mdub555/SplitFlapDisplay/CAD Files/v2/Character Drum - Character Drum Main.FCStd

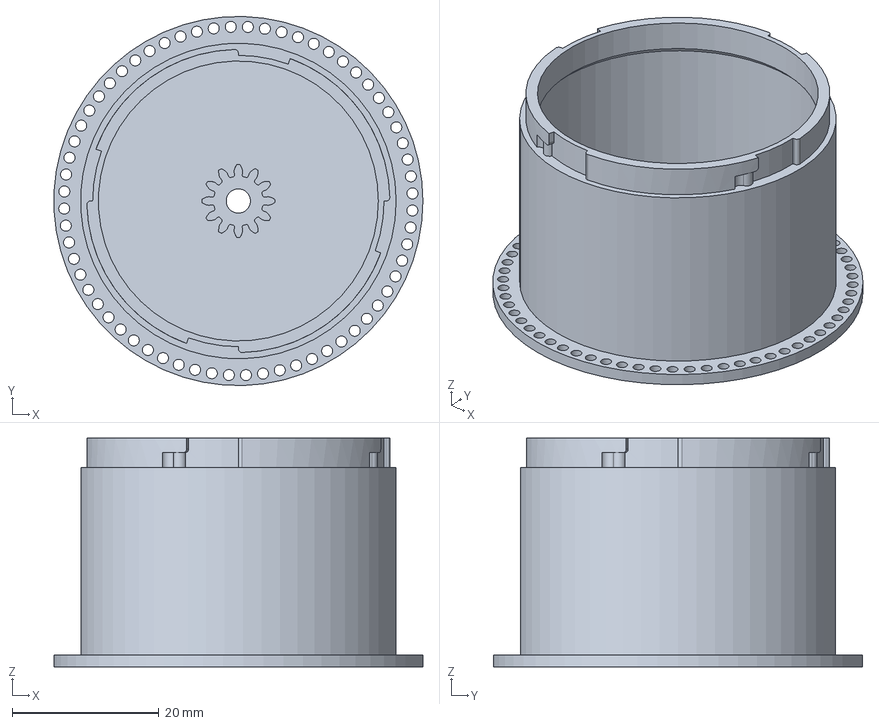
[picture p1: CAD file, 2026-08-30]
CAD Files/v2/Character Drum - Character Drum Main.FCStd
50.3 x 50.3 x 31.2 mm
