mdub555/SplitFlapDisplay/CAD Files/64FlapsWithLetters (parts and bambu print profile)/Flap 57 - Blank.FCStd

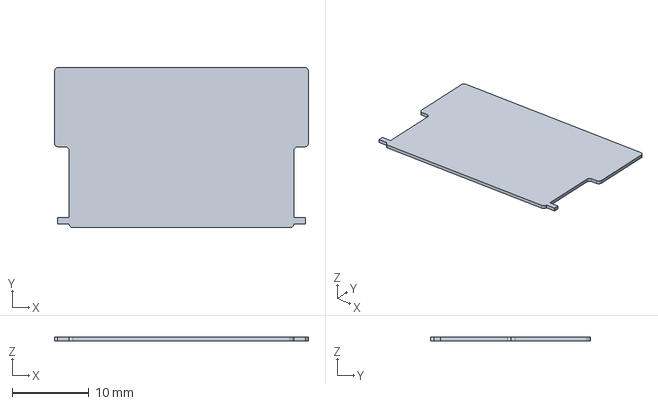
[picture p2: CAD file, 2026-08-14]
CAD Files/64FlapsWithLetters (parts and bambu print profile)/Flap 57 - Blank.FCStd
33.1 x 20.9 x 0.48 mm
