mdub555/SplitFlapDisplay/CAD Files/v2/Module Enclosure - Enclosure Cover Back.FCStd

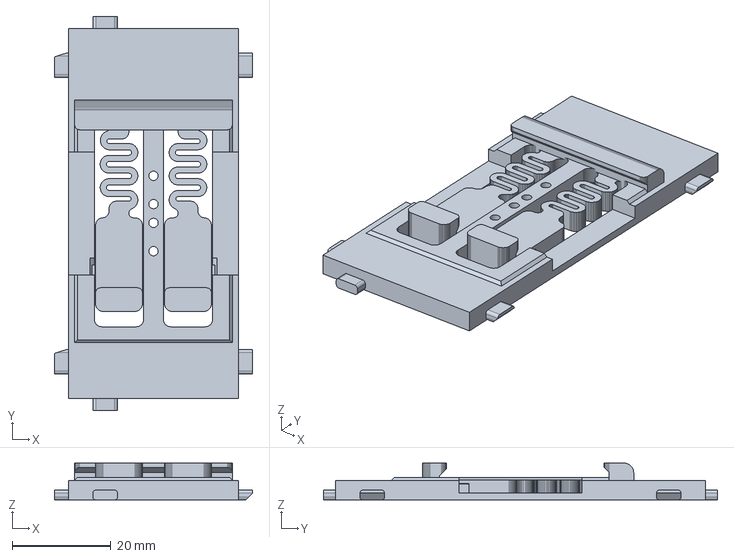
[picture p3: CAD file, 2026-09-11]
CAD Files/v2/Module Enclosure - Enclosure Cover Back.FCStd
40.2 x 80.0 x 7.50 mm
