mdub555/SplitFlapDisplay/PCBs/bus-board-8-module/bus-board-8-module.step

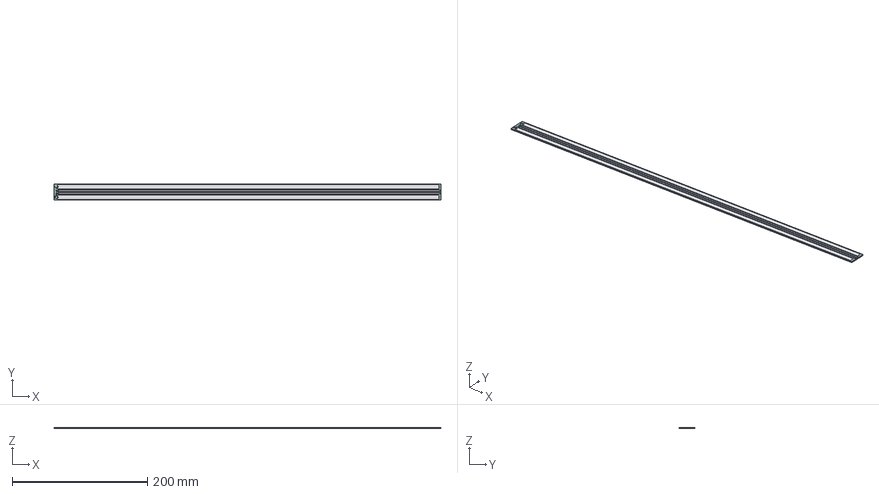
[picture p4: CAD file, 2026-08-30]
PCBs/bus-board-8-module/bus-board-8-module.step
572.6 x 24.0 x 1.62 mm
SplitFlapBusBoard_pad
SplitFlapBusBoard_silkscreen
SplitFlapBusBoard_PCB
