mdub555/SplitFlapDisplay/CAD Files/v2/Din Rail Spacer.FCStd

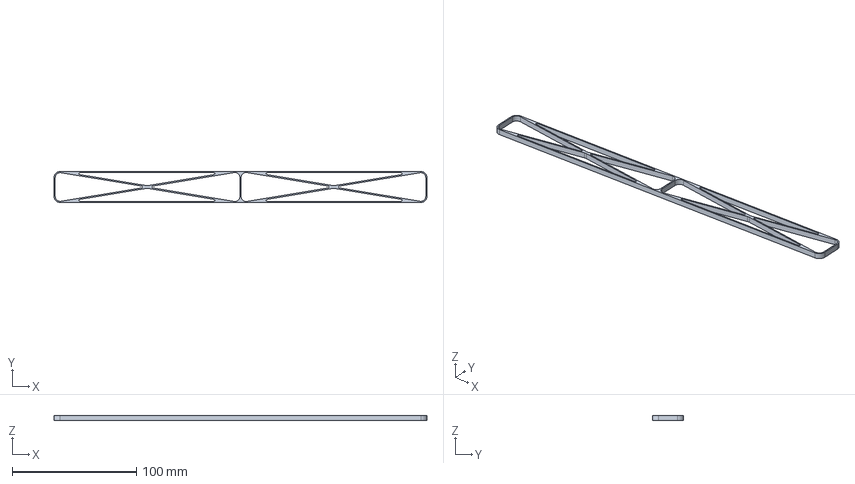
[picture p5: CAD file, 2026-09-11]
CAD Files/v2/Din Rail Spacer.FCStd
300.0 x 25.0 x 4.20 mm
