mdub555/SplitFlapDisplay/CAD Files/v2/Module Enclosure - Enclosure Cover Top.FCStd

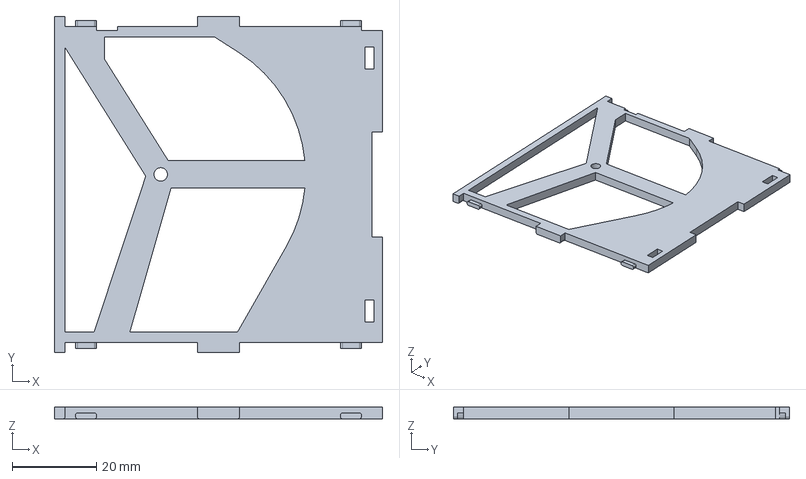
[picture p6: CAD file, 2026-08-30]
CAD Files/v2/Module Enclosure - Enclosure Cover Top.FCStd
78.0 x 80.0 x 2.80 mm
