mdub555/SplitFlapDisplay/CAD Files/v2/Flap Set Holder.FCStd

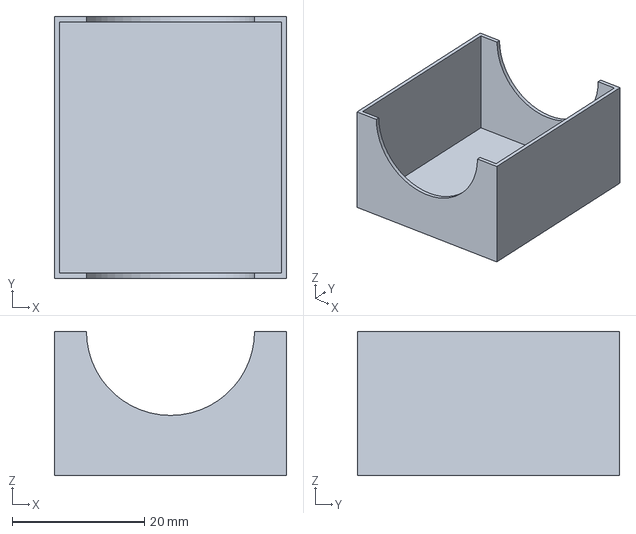
[picture p7: CAD file, 2026-08-30]
CAD Files/v2/Flap Set Holder.FCStd
35.1 x 39.6 x 21.8 mm
