mdub555/SplitFlapDisplay/CAD Files/v2/Character Drum - Character Drum Lip.FCStd

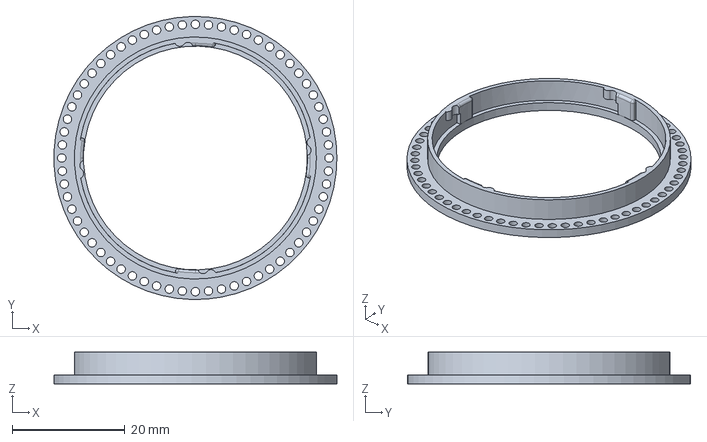
[picture p8: CAD file, 2026-08-30]
CAD Files/v2/Character Drum - Character Drum Lip.FCStd
50.3 x 50.3 x 5.60 mm
