mdub555/SplitFlapDisplay/CAD Files/v2/Center Gear.FCStd

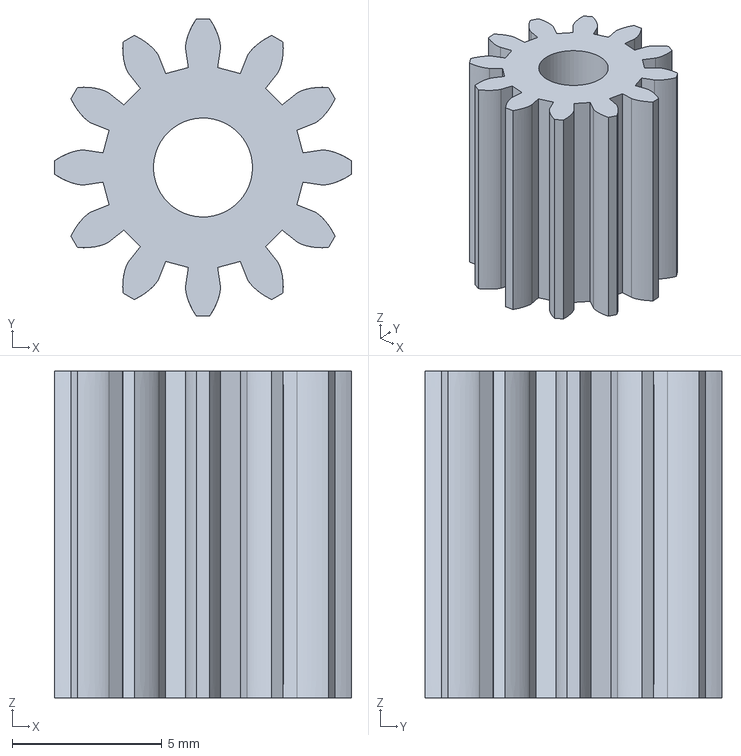
[picture p9: CAD file, 2026-08-14]
CAD Files/v2/Center Gear.FCStd
9.92 x 9.92 x 10.9 mm
