mdub555/SplitFlapDisplay/CAD Files/v2/Wire Retainer.FCStd

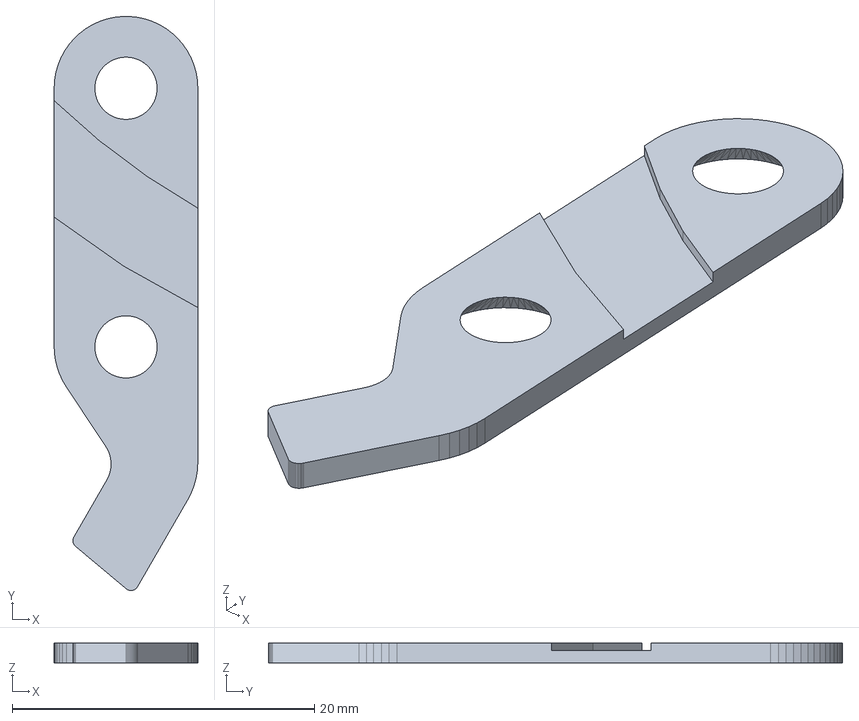
[picture p10: CAD file, 2026-08-14]
CAD Files/v2/Wire Retainer.FCStd
9.52 x 38.0 x 1.30 mm
