mdub555/SplitFlapDisplay/CAD Files/v2/Gear Plate.FCStd

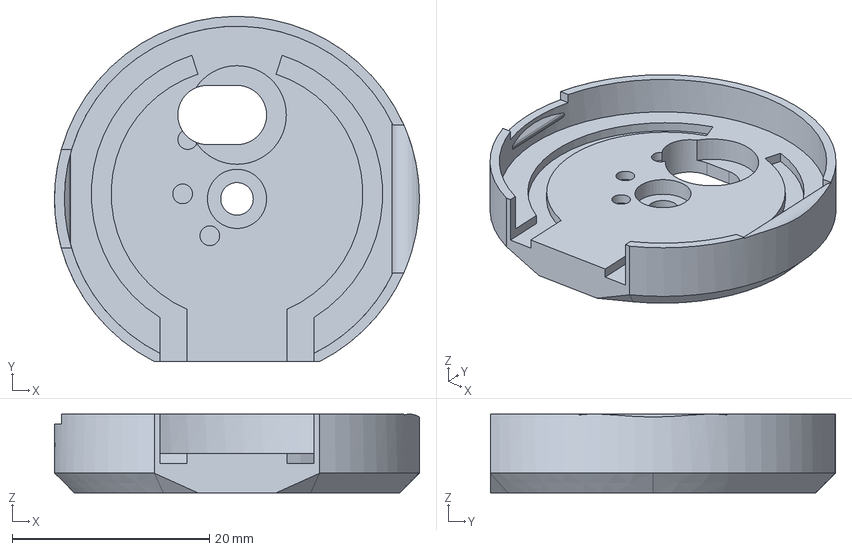
[picture p11: CAD file, 2026-08-14]
CAD Files/v2/Gear Plate.FCStd
37.0 x 35.0 x 8.00 mm
