mdub555/SplitFlapDisplay/CAD Files/v2/Motor Gear.FCStd

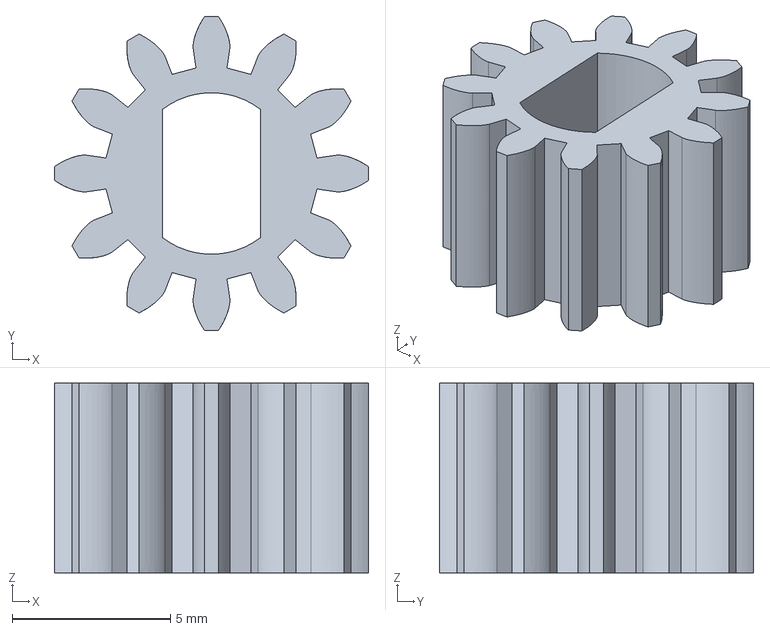
[picture p12: CAD file, 2026-08-14]
CAD Files/v2/Motor Gear.FCStd
9.92 x 9.92 x 6.00 mm
