mdub555/SplitFlapDisplay/CAD Files/v2/Module Enclosure - Enclosure Cover Bottom.FCStd

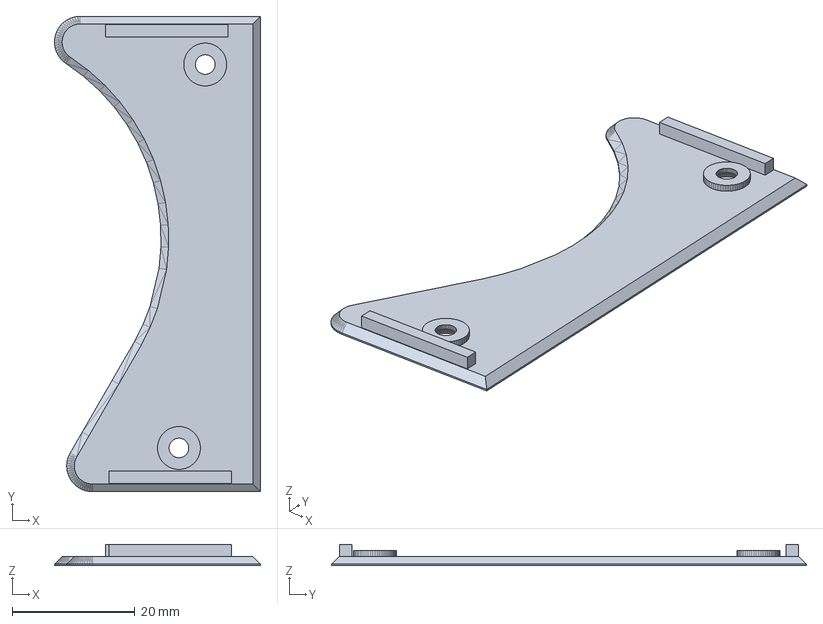
[picture p13: CAD file, 2026-08-14]
CAD Files/v2/Module Enclosure - Enclosure Cover Bottom.FCStd
33.6 x 77.6 x 3.50 mm
