mdub555/SplitFlapDisplay/frontend/setup.txt

$ sudo rpi-update
$ sudo apt update
$ sudo apt upgrade
# set up wifi again with nmtui
$ sudo apt-get install neovim
$ sudo apt-get install tmux

# install docker: https://docs.docker.com/engine/install/raspberry-pi-os/
$ sudo apt-get update
$ sudo apt-get install ca-certificates curl
$ sudo install -m 0755 -d /etc/apt/keyrings
$ sudo curl -fsSL https://download.docker.com/linux/raspbian/gpg -o /etc/apt/keyrings/docker.asc
$ sudo chmod a+r /etc/apt/keyrings/docker.asc
$ echo \
  "deb [arch=$(dpkg --print-architecture) signed-by=/etc/apt/keyrings/docker.asc] https://download.docker.com/linux/debian \
  $(. /etc/os-release && echo "$VERSION_CODENAME") stable" | \
  sudo tee /etc/apt/sources.list.d/docker.list > /dev/null
$ sudo apt-get update
$ sudo apt-get install docker-ce docker-ce-cli containerd.io docker-buildx-plugin docker-compose-plugin
$ sudo groupadd docker
$ sudo usermod -aG docker $USER
$ newgrp docker

# install comitup: https://github.com/davesteele/comitup
$ sudo apt install comitup
