mdub555/SplitFlapDisplay/PCBs/bus-board-8-module/bus-board-8-module.kicad_pcb

## KiCad design PCBs/bus-board-8-module/bus-board-8-module.kicad_pcb (2026-08-30)

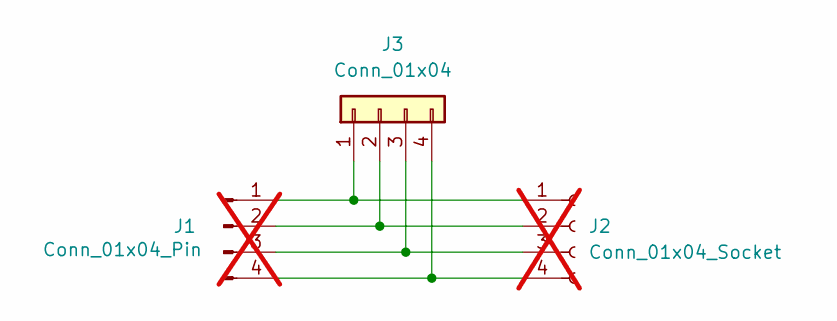
[picture p14: schematic bus-board-8-module.kicad_sch]

Parts:
J1: Conn_01x04_Pin; PinHeader_1x04_P2.54mm_Vertical; not fitted
J2: Conn_01x04_Socket; PinSocket_1x04_P2.54mm_Vertical; not fitted
J3: Conn_01x04; bus-8-5v

Connections:
unnamed: J1.1, J2.1, J3.1
unnamed: J1.2, J2.2, J3.2
unnamed: J1.3, J2.3, J3.3
unnamed: J1.4, J2.4, J3.4

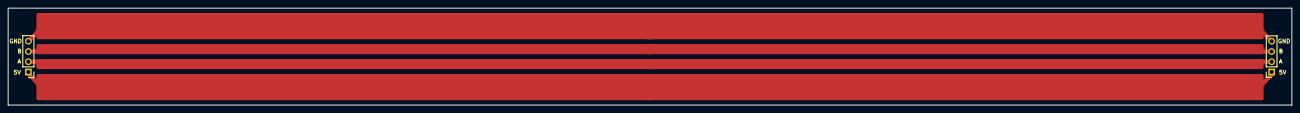
[picture p15: board bus-board-8-module.kicad_pcb from above]

Board: 2 copper layers, 318.0 x 24.0 mm, 3 parts (0 on the bottom side), 4 nets.
