mdub555/SplitFlapDisplay/PCBs/driver-v5/driver-v5.kicad_pcb

## KiCad design PCBs/driver-v5/driver-v5.kicad_pcb (2026-08-30)

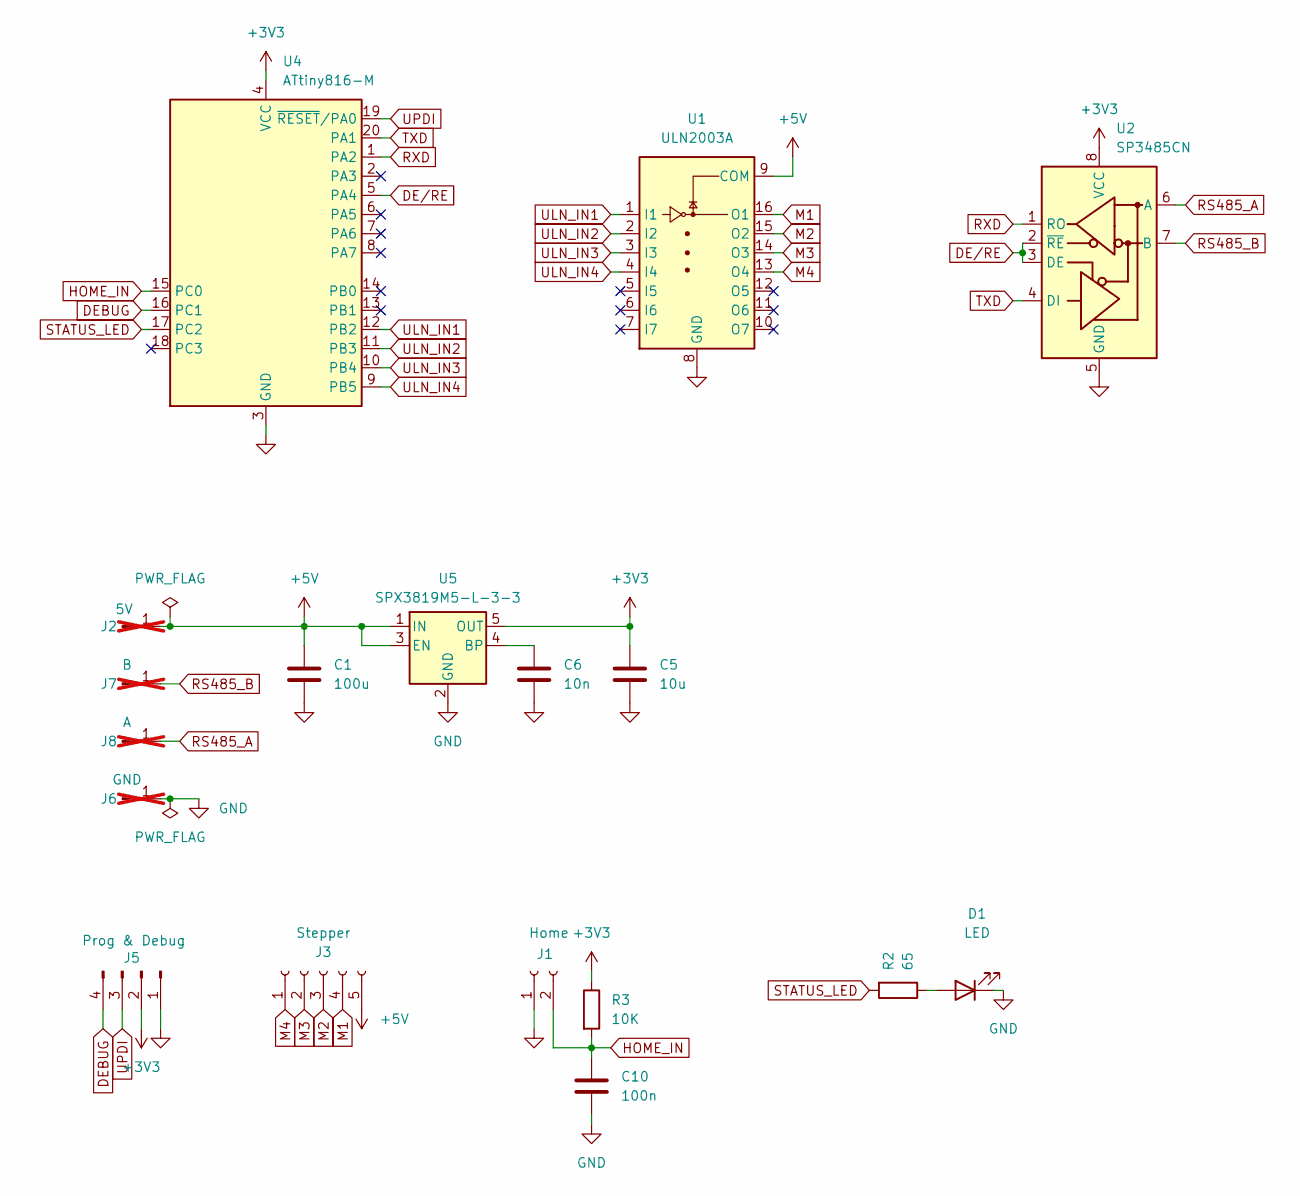
[picture p16: schematic driver-v5.kicad_sch]

Parts:
C1: 100u; C_Elec_5x5.4
C5: 10u; C_0603_1608Metric
C6: 10n; C_0603_1608Metric
C10: 100n; C_0603_1608Metric
D1: LED; LED_0603_1608Metric
J1: Home; PinSocket_1x02_P2.54mm_Vertical
J2: 5V; PinHeader_1x01_P2.54mm_Vertical; not fitted
J3: Stepper; JST_XH_B5B-XH-A_1x05_P2.50mm_Vertical
J5: Prog & Debug; PinHeader_1x04_P2.54mm_Vertical
J6: GND; PinHeader_1x01_P2.54mm_Vertical; not fitted
J7: B; PinHeader_1x01_P2.54mm_Vertical; not fitted
J8: A; PinHeader_1x01_P2.54mm_Vertical; not fitted
R2: 65; R_0603_1608Metric
R3: 10K; R_0603_1608Metric
U1: ULN2003A; SOIC-16_3.9x9.9mm_P1.27mm
U2: SP3485CN; SOIC-8_3.9x4.9mm_P1.27mm
U4: ATtiny816-M; VQFN-20-1EP_3x3mm_P0.4mm_EP1.7x1.7mm
U5: SPX3819M5-L-3-3; SOT-23-5

Connections:
+3V3: C5.1, J5.2, R3.1, U2.8 (VCC), U4.4 (VCC), U5.5 (OUT)
+5V: C1.1, J2.1 (Pin_1_1), J3.5, U1.9 (COM), U5.1 (IN), U5.3 (EN)
DEBUG: J5.4, U4.16 (PC1)
DE/RE: U2.2 (~RE), U2.3 (DE), U4.5 (PA4)
GND: C1.2, C5.2, C6.2, C10.2, D1.1 (K), J1.1, J5.1, J6.1 (Pin_1_1), U1.8 (GND), U2.5 (GND), U4.3 (GND), U4.21 (GND), U5.2 (GND)
HOME_IN: C10.1, J1.2, R3.2, U4.15 (PC0)
M1: J3.4, U1.16 (O1)
M2: J3.3, U1.15 (O2)
M3: J3.2, U1.14 (O3)
M4: J3.1, U1.13 (O4)
unnamed: D1.2 (A), R2.1
unnamed: C6.1, U5.4 (BP)
RS485_A: J8.1 (Pin_1_1), U2.6 (A)
RS485_B: J7.1 (Pin_1_1), U2.7 (B)
RXD: U2.1 (RO), U4.1 (PA2)
STATUS_LED: R2.2, U4.17 (PC2)
TXD: U2.4 (DI), U4.20 (PA1)
ULN_IN1: U1.1 (I1), U4.12 (PB2)
ULN_IN2: U1.2 (I2), U4.11 (PB3)
ULN_IN3: U1.3 (I3), U4.10 (PB4)
ULN_IN4: U1.4 (I4), U4.9 (PB5)
UPDI: J5.3, U4.19 (~RESET/PA0)

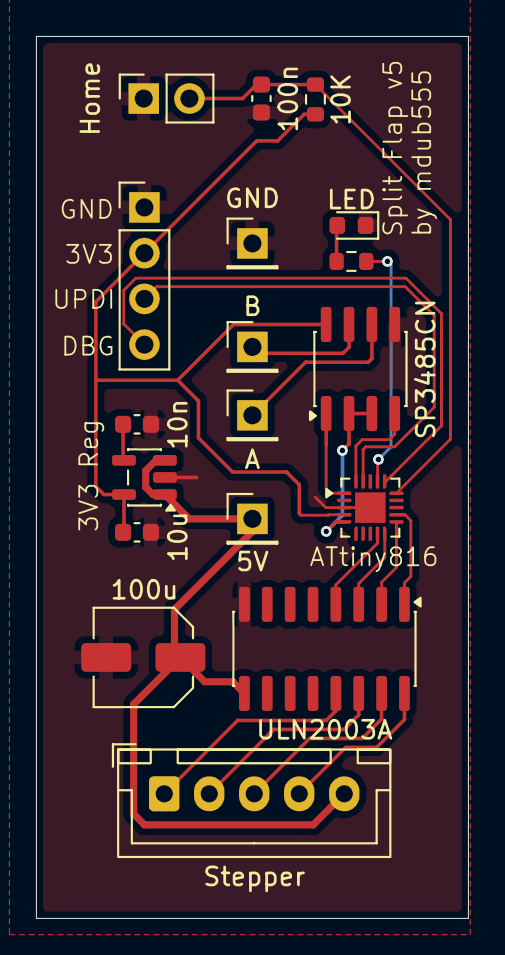
[picture p17: board driver-v5.kicad_pcb from above]

Board: 4 copper layers, 24.0 x 49.0 mm, 18 parts (0 on the bottom side), 22 nets.
