mdub555/SplitFlapDisplay/firmware/splitflapfirmwarev8/splitflapfirmwarev8.ino

// ==============================================================================
// Split-Flap Display Module Firmware
// ==============================================================================
// Each ATTiny runs this firmware to control one character cell of a split-flap
// display. The cell is driven by a 28BYJ-48 stepper motor which rotates a reel
// of physical flaps past a viewing window. Two wires detect the home flap when
// a strip of aluminum tape on the home flap comes in contact with them.
//
// Multiple modules are wired together on an RS-485 serial bus and addressed by
// a unique numeric ID. A Raspberry Pi sends commands over the bus; each module
// listens for its own ID and responds accordingly. See transceiver.h for the
// full message grammar and command reference.
//
// This file wires together all of the individual components and handles the
// controlling logic for incoming requests on the bus.
// ==============================================================================

#include <Arduino.h>
#include <avr/wdt.h>

#include "debug_serial.h"
#include "eeprom_store.h"
#include "home_sensor.h"
#include "motor.h"
#include "pinout.h"
#include "splitflap.h"
#include "transceiver.h"

// Default unset ID, to be updated via the frontend on installation.
// This is burned into EEPROM on first boot if no saved ID exists.
const uint8_t HARDCODED_ID = EepromStore::UNPROVISIONED_ID;

const long RS485_BAUD = 9600;

Transceiver transceiver;
DebugSerial debugSerial;  // TX only, on DEBUG_PIN at 19200 baud
SplitFlap splitFlap(&debugSerial);
Command command;

// A dump requested while the module is busy (moving, homing, calibrating) is
// sent once it finishes, so a dump after a calibrate reports the result.
// A broadcast dump is answered in this module's slot: ID x DUMP_SLOT_MS after
// the request, or after the module goes idle if it was busy, so every
// module's reply has the bus to itself. A typical dump is ~75 bytes (about
// 78 ms at 9600 baud) and one with large values ~89 bytes (93 ms); a slot
// fits that with room for the line turnaround and timing skew.
const uint8_t DUMP_SLOT_MS = 105;
bool dumpPending = false;
uint16_t dumpDelayMs = 0;  // wait before replying, once idle
uint32_t dumpAtMs = 0;     // millis() to reply at
// A flap offset dump ('%') waits for the module to be idle in
// the same way. It's only ever addressed to this module, so has no slot.
bool flapOffsetsPending = false;

// Starts a dump: right away for one addressed to this module, or in this
// module's slot for a broadcast. Unprovisioned modules don't answer a
// broadcast, since they'd all share the last slot.
void requestDump(bool broadcast) {
  uint8_t id = EepromStore::getModuleId();
  if (broadcast && id == EepromStore::UNPROVISIONED_ID) return;
  dumpDelayMs = broadcast ? id * DUMP_SLOT_MS : 0;
  dumpAtMs = millis() + dumpDelayMs;
  dumpPending = true;
}

// Call every loop(). Sends a requested dump once the module is idle and its
// delay has passed.
void updateDump() {
  if (!dumpPending && !flapOffsetsPending) return;
  if (splitFlap.busy()) {
    dumpAtMs = millis() + dumpDelayMs;  // the wait starts once idle
    return;
  }
  if (flapOffsetsPending) {
    flapOffsetsPending = false;
    transceiver.dumpFlapOffsets();
  }
  if (dumpPending && (int32_t)(millis() - dumpAtMs) >= 0) {
    dumpPending = false;
    transceiver.dump(splitFlap.revolutionCount(), splitFlap.lastDrift());
  }
}

// millis() when identify ('b') was received, and whether it's still going.
uint32_t identifyStartMs = 0;
bool identifying = false;
const uint16_t IDENTIFY_MS = 10000;

// Blink rates for the status LED, as the bit of millis() that toggles the
// LED: bit N gives a period of 2^(N+1) ms.
const uint16_t BLINK_8HZ = 64;   // 128 ms period
const uint16_t BLINK_4HZ = 128;  // 256 ms period
const uint16_t BLINK_1HZ = 512;  // 1024 ms period

// The status LED, in order of priority:
//   fast blink (8 Hz)  identify was requested in the last 10 seconds
//   4 Hz blink         the last home or calibration failed (see lastError())
//   1 Hz blink         unprovisioned (ID 255)
//   solid              homing or calibrating
//   off                otherwise
void updateStatusLed() {
  uint16_t now = millis();  // the low bits are all the blink phases need
  bool on;
  if (identifying && millis() - identifyStartMs < IDENTIFY_MS) {
    on = now & BLINK_8HZ;
  } else {
    identifying = false;
    if (splitFlap.lastError() != SPLITFLAP_OK) {
      on = now & BLINK_4HZ;
    } else if (EepromStore::getModuleId() == EepromStore::UNPROVISIONED_ID) {
      on = now & BLINK_1HZ;
    } else {
      on = splitFlap.isHoming();
    }
  }
  digitalWriteFast(STATUS_LED, on);
}

// Restarts the module, the same as a power cycle apart from the brief delay.
void reboot() {
  _PROTECTED_WRITE(RSTCTRL.SWRR, RSTCTRL_SWRE_bm);
}

// Start up the various components inside the module.
void setup() {
  pinMode(STATUS_LED, OUTPUT);
  EepromStore::begin(HARDCODED_ID);
  HomeSensor::begin();
  Motor::begin();
  transceiver.begin(RS485_BAUD);
  debugSerial.begin();
  splitFlap.begin();
  // Watchdog: if loop() stops running for about 2 seconds (a hang), the
  // module resets itself. loop() feeds it every iteration.
  _PROTECTED_WRITE(WDT.CTRLA, WDT_PERIOD_2KCLK_gc);
}

// Carries out one command received on the bus.
void handleCommand(const Command& command) {
  switch (command.type) {
    case DISPLAY_CHAR:
      splitFlap.moveToChar(command.data.dataChar);
      break;

    case DISPLAY_INDEX:
      splitFlap.moveToIndex(command.data.dataInt);
      break;

    case HOME:
      splitFlap.home();
      break;

    case CALIBRATE:
      splitFlap.calibrate();
      break;

    case SET_OFFSET:
      // 0 is a special case that means make the current position flap 0
      if (command.data.dataInt == 0) {
        splitFlap.setHomeOffsetHere();
      } else {
        splitFlap.setHomeOffset(command.data.dataInt);
      }
      break;

    case SET_TOTAL_STEPS:
      splitFlap.setTotalSteps(command.data.dataInt);
      break;

    case SET_DEBOUNCE_MS:
      EepromStore::saveDebounceMs(command.data.dataInt);
      break;

    case NUDGE:
      splitFlap.nudge(command.data.dataInt);
      break;

    case MOVE_TO_STEP:
      splitFlap.goToRawStep(command.data.dataInt);
      break;

    case SET_HOMING_STEP_DELAY:
      EepromStore::saveHomingStepDelayUs(command.data.dataInt);
      break;

    case SET_STEP_DELAY:
      EepromStore::saveStepDelayUs(command.data.dataInt);
      break;

    case SET_MODULE_ID:
      EepromStore::saveModuleId(command.data.dataInt);
      break;

    case SET_AUTO_HOME:
      EepromStore::saveAutoHome(command.data.dataInt);
      break;

    case SET_MOTOR_CW:
      splitFlap.setMotorClockwise(command.data.dataInt);
      break;

    case SET_MOTOR_RELEASE:
      EepromStore::saveReleaseMotor(command.data.dataInt);
      if (command.data.dataInt) {
        Motor::release();
      } else {
        Motor::tense();
      }
      break;

    case SET_RECALCULATE_HOME:
      EepromStore::saveRecalculateHome(command.data.dataInt);
      break;

    case DUMP_STATE:
      requestDump(command.broadcast);
      break;

    case STOP:
      splitFlap.stop();
      break;

    case IDENTIFY:
      identifying = true;
      identifyStartMs = millis();
      break;

    case REBOOT:
      reboot();
      break;

    case FRAME:
      splitFlap.moveToCharAfter(command.data.dataChar, command.frameDelayMs);
      break;

    case EXERCISE:
      splitFlap.exercise(command.data.dataInt);
      break;

    case RESET_SETTINGS:
      EepromStore::writeDefaults(EepromStore::getModuleId());
      // Settings like total steps change under the current position, so
      // start clean.
      reboot();
      break;

    case SET_RAMP_START_DELAY:
      EepromStore::saveRampStartDelayUs(command.data.dataInt);
      break;

    case SET_RAMP_STEPS:
      EepromStore::saveRampSteps(command.data.dataInt);
      break;

    case SET_SETTLE_MS:
      EepromStore::saveSettleMs(command.data.dataInt);
      break;

    case SET_STAGGER_MS:
      EepromStore::saveStaggerMs(command.data.dataInt);
      break;

    case SET_FLAP_OFFSET:
      splitFlap.setFlapOffset(command.data.dataInt);
      break;

    case DUMP_FLAP_OFFSETS:
      flapOffsetsPending = true;
      break;

    default:
      break;
  }
}

void loop() {
  wdt_reset();
  splitFlap.update();
  updateStatusLed();
  updateDump();

  if (transceiver.poll(command)) {
    // Log the message as received rather than a description per command,
    // which keeps the debug strings (and flash use) small.
    debugSerial.println(transceiver.message());
    handleCommand(command);
  }
}
