mdub555/SplitFlapDisplay/firmware/splitflapfirmwarev8/pinout.h

#ifndef PINOUT_H
#define PINOUT_H

#define HOME_PIN PIN_PC0

#define DEBUG_PIN PIN_PC1

#define STATUS_LED PIN_PC2

#define MOTOR_IN1 PIN_PB2
#define MOTOR_IN2 PIN_PB3
#define MOTOR_IN3 PIN_PB4
#define MOTOR_IN4 PIN_PB5

// Defining hardware serial pins is not necessary
// TXD = PIN_PA1
// RXD = PIN_PA2
// DE/RE = PIN_PA4

#endif
