mdub555/SplitFlapDisplay/firmware/splitflapfirmwarev8/transceiver.cpp

#include "transceiver.h"

#include <Arduino.h>

#include "eeprom_store.h"

namespace {
  enum ParseState {
    IDLE,               // looking for the first 'm'
    READING_ID,         // digits or '*', dispatches command on first non-digit
    READING_CMD,        // reading a single character which corresponds to the command
    READING_DATA_CHAR,  // reading a single character for the char to display
    READING_DATA_INT,   // reading in multiple digits for one of many commands
  };

  // How a command's data is read, and for numbers, the accepted range.
  // Checking ranges here, in one place, is much smaller than a check in each
  // setter in the .ino.
  enum ArgKind : uint8_t {
    ARG_NONE,             // no data: the command is complete once its letter is read
    ARG_CHAR,             // a single character
    ARG_INT_ANY,          // a number 0-65535
    ARG_INT_BOOLEAN,      // 0-1
    ARG_INT_BYTE,         // 0-255
    ARG_INT_NONZERO,      // 1-65535: 0 would remove a step delay entirely, or
                          // break the movement math as total steps
    ARG_INT_BELOW_TOTAL,  // 0 to total steps - 1
  };

  struct CommandSpec {
    char code;         // the command's letter on the wire
    CommandType type;
    ArgKind arg;
  };

  // The letters also used outside COMMANDS: the frame header, and the
  // replies, each marked with the letter of the command it answers.
  const char FRAME_CODE = 'f';
  const char DUMP_CODE = '?';
  const char FLAP_OFFSETS_CODE = '%';

  // Labels for the dump's two read-only fields. The settings in a dump are
  // labelled with the letter that sets them.
  const char REVOLUTIONS_CODE = '#';
  const char DRIFT_CODE = '~';

  // Every command that can be sent by letter, grouped as in transceiver.h.
  // FRAME isn't here: it's only reached through the frame header.
  const CommandSpec COMMANDS[] = {
    // Actions
    {'-', DISPLAY_CHAR,          ARG_CHAR},
    {'+', DISPLAY_INDEX,         ARG_INT_BYTE},  // moveToIndex() ignores indexes past the last flap
    {'h', HOME,                  ARG_NONE},
    {'c', CALIBRATE,             ARG_NONE},
    {'n', NUDGE,                 ARG_INT_BELOW_TOTAL},
    {'g', MOVE_TO_STEP,          ARG_INT_BELOW_TOTAL},
    {'x', STOP,                  ARG_NONE},
    {'e', EXERCISE,              ARG_INT_BYTE},
    {'b', IDENTIFY,              ARG_NONE},
    {'r', REBOOT,                ARG_NONE},
    // Module
    {DUMP_CODE, DUMP_STATE,      ARG_NONE},
    {'!', RESET_SETTINGS,        ARG_NONE},
    {'@', SET_MODULE_ID,         ARG_INT_BYTE},
    {FLAP_OFFSETS_CODE, DUMP_FLAP_OFFSETS, ARG_NONE},
    // Settings
    {'O', SET_OFFSET,            ARG_INT_BELOW_TOTAL},
    {'T', SET_TOTAL_STEPS,       ARG_INT_NONZERO},
    {'D', SET_DEBOUNCE_MS,       ARG_INT_ANY},
    {'E', SET_RECALCULATE_HOME,  ARG_INT_BOOLEAN},
    {'A', SET_AUTO_HOME,         ARG_INT_BOOLEAN},
    {'C', SET_MOTOR_CW,          ARG_INT_BOOLEAN},
    {'F', SET_MOTOR_RELEASE,     ARG_INT_BOOLEAN},
    {'S', SET_STEP_DELAY,        ARG_INT_NONZERO},
    {'H', SET_HOMING_STEP_DELAY, ARG_INT_NONZERO},
    {'R', SET_RAMP_START_DELAY,  ARG_INT_NONZERO},
    {'L', SET_RAMP_STEPS,        ARG_INT_BYTE},
    {'W', SET_SETTLE_MS,         ARG_INT_BYTE},
    {'P', SET_STAGGER_MS,        ARG_INT_BYTE},
    {'J', SET_FLAP_OFFSET,       ARG_INT_BYTE},
  };

  // The COMMANDS entry for the letter `c`, or nullptr if there isn't one.
  const CommandSpec* findCommand(char c) {
    for (const CommandSpec& spec : COMMANDS) {
      if (spec.code == c) return &spec;
    }
    return nullptr;
  }

  // Finishes a numeric command, rejecting it if it had no digits (a truncated
  // "m05S" must not set a 0 µs delay) or its value is out of range.
  bool finishDataInt(Command& command, ArgKind arg, uint16_t value, bool hasDigits) {
    if (!hasDigits) return false;
    uint16_t max = 0xFFFF;
    switch (arg) {
      case ARG_INT_BOOLEAN:     max = 1; break;
      case ARG_INT_BYTE:        max = 255; break;
      case ARG_INT_NONZERO:     if (value == 0) return false; break;
      case ARG_INT_BELOW_TOTAL: max = EepromStore::getTotalSteps() - 1; break;
      case ARG_INT_ANY:
      case ARG_NONE:
      case ARG_CHAR:            break;
    }
    if (value > max) return false;
    command.data.dataInt = value;
    return true;
  }

  __attribute__((noinline)) bool toCommand(Command& command, const char* buffer, uint8_t bufferLen) {
    command.data.dataInt = 0;
    command.type = UNKNOWN_COMMAND;
    command.broadcast = false;
    ParseState parseState = IDLE;
    // Wider than a module ID so an ID above 255 can't wrap around and match
    // a real module (e.g. "m261" must not reach module 5).
    uint16_t id = 0;
    bool hasId = false;
    uint16_t value = 0;
    bool hasDigits = false;
    ArgKind arg = ARG_NONE;
    for (uint8_t i = 0; i < bufferLen; i++) {
      char c = buffer[i];
      switch (parseState) {
        // Idle — watch for 'm' start-of-message marker.
        case IDLE:
          if (c == 'm') {
            parseState = READING_ID;
          }
          break;

        // Accumulate the module ID field ('*', or one or more digits), then
        // start reading the command on the first character after it.
        case READING_ID:
          if (isDigit(c)) {
            if (id <= 255) {
              id *= 10;
              id += c - '0';
            }
            hasId = true;
            break;
          }
          if (c == '*' && !hasId) {
            command.broadcast = true;
            parseState = READING_CMD;
            break;
          }
          // A missing ID mustn't read as module 0.
          if (!hasId || id != EepromStore::getModuleId()) {
            return false;
          }
          parseState = READING_CMD;
          // fall through: this character is the command

        case READING_CMD: {
            const CommandSpec* spec = findCommand(c);
            if (!spec) return false;
            command.type = spec->type;
            arg = spec->arg;
            // A broadcast ID change would give every module the same ID, so
            // only an unprovisioned module accepts one.
            if (command.type == SET_MODULE_ID && command.broadcast &&
                EepromStore::getModuleId() != EepromStore::UNPROVISIONED_ID) {
              return false;
            }
            // Flap offsets are per module, and every module's offset dump at
            // once would collide on the bus.
            if ((command.type == SET_FLAP_OFFSET || command.type == DUMP_FLAP_OFFSETS) &&
                command.broadcast) {
              return false;
            }
            switch (arg) {
              case ARG_NONE:
                return true;
              case ARG_CHAR:
                parseState = READING_DATA_CHAR;
                break;
              default:  // every ARG_INT_* kind
                parseState = READING_DATA_INT;
                break;
            }
            break;
          }

        // Numeric commands — accumulate digits, execute on any non-digit
        // terminator (typically '\n'). Values that don't fit in 16 bits are
        // rejected.
        case READING_DATA_INT:
          if (isDigit(c)) {
            uint8_t digit = c - '0';
            // Reject anything above 65535 rather than wrapping.
            if (value > 6553 || (value == 6553 && digit > 5)) {
              return false;
            }
            value = value * 10 + digit;
            hasDigits = true;
          } else {
            return finishDataInt(command, arg, value, hasDigits);
          }
          break;

        case READING_DATA_CHAR:
          command.data.dataChar = c;
          return true;
      }
    }
    // The buffer ended without a terminator (the '\n' is stripped by poll(),
    // and the 50ms timeout path never has one). Only a number can end there;
    // anything else was cut short.
    if (parseState == READING_DATA_INT) {
      return finishDataInt(command, arg, value, hasDigits);
    }
    return false;
  }
}

void Transceiver::begin(long baud) {
  // Swap pins, since I'm using PA1, PA2, and PA4, which are secondary
  Serial.swap(1);
  // The megaTinyCore library natively supports RS-485, which removes the need
  // to manually set the DE pin high or low, as long as you're using the
  // default XDIR pin (which is PA4 after Serial.swap(1)).
  Serial.begin(baud, SERIAL_8N1 | SERIAL_RS485);
}

namespace {
  // Starts a reply: m, this module's ID (at least two digits), and the
  // letter of the command it answers.
  void printReplyHeader(char code) {
    Serial.print('m');
    uint8_t id = EepromStore::getModuleId();
    if (id < 10) Serial.print('0');
    Serial.print(id);
    Serial.print(code);
  }

  void printHexDigit(uint8_t digit) {
    Serial.print((char)(digit < 10 ? '0' + digit : 'A' - 10 + digit));
  }

  // Starts a dump field: a tab, then the field's label.
  void printFieldLabel(char code) {
    Serial.print('\t');
    Serial.print(code);
  }

  // Prints a setting as a dump field, labelled with the letter that sets it.
  // One call per field keeps dump() small.
  void printField(CommandType type, uint16_t value) {
    for (const CommandSpec& spec : COMMANDS) {
      if (spec.type == type) printFieldLabel(spec.code);
    }
    Serial.print(value);
  }
}

void Transceiver::dump(uint32_t revolutions, int16_t drift) {
  printReplyHeader(DUMP_CODE);
  printField(SET_OFFSET, EepromStore::getHomeOffset());
  printField(SET_TOTAL_STEPS, EepromStore::getTotalSteps());
  printField(SET_DEBOUNCE_MS, EepromStore::getDebounceMs());
  printField(SET_STEP_DELAY, EepromStore::getStepDelayUs());
  printField(SET_HOMING_STEP_DELAY, EepromStore::getHomingStepDelayUs());
  printField(SET_MOTOR_CW, EepromStore::isMotorClockwise());
  printField(SET_AUTO_HOME, EepromStore::autoHomeEnabled());
  printField(SET_MOTOR_RELEASE, EepromStore::releaseMotorEnabled());
  printField(SET_RECALCULATE_HOME, EepromStore::recalculateHome());
  printField(SET_RAMP_START_DELAY, EepromStore::getRampStartDelayUs());
  printField(SET_RAMP_STEPS, EepromStore::getRampSteps());
  printField(SET_SETTLE_MS, EepromStore::getSettleMs());
  printField(SET_STAGGER_MS, EepromStore::getStaggerMs());
  printFieldLabel(REVOLUTIONS_CODE);
  Serial.print(revolutions);
  printFieldLabel(DRIFT_CODE);
  Serial.println(drift);
}

void Transceiver::dumpFlapOffsets() {
  printReplyHeader(FLAP_OFFSETS_CODE);
  for (uint8_t flap = 0; flap < EepromStore::NUM_FLAP_OFFSETS; flap++) {
    uint8_t offset = EepromStore::getFlapOffset(flap);
    printHexDigit(offset >> 4);
    printHexDigit(offset & 0xF);
  }
  Serial.println();
}

const char* Transceiver::message() const { return buffer; }

bool Transceiver::parseBuffer(Command& command) {
  buffer[bufferLen] = '\0';  // for message()
  bool gotCommand = toCommand(command, buffer, bufferLen);
  bufferLen = 0;
  return gotCommand;
}

void Transceiver::checkFrameHeader() {
  // "m*f" then at least one digit then ':'
  if (bufferLen < 5 || buffer[0] != 'm' || buffer[1] != '*' || buffer[2] != FRAME_CODE) return;
  uint16_t interval = 0;
  for (uint8_t i = 3; i < bufferLen - 1; i++) {
    if (!isDigit(buffer[i])) return;
    interval = interval * 10 + (buffer[i] - '0');
    if (interval > 255) return;
  }
  inFrame = true;
  framePos = 0;
  frameInterval = interval;
  frameHit = false;
}

bool Transceiver::frameByte(char c, Command& command) {
  if (c == '\n') {
    inFrame = false;
    buffer[bufferLen] = '\0';  // the header, for message()
    bufferLen = 0;
    if (!frameHit) return false;
    command.type = FRAME;
    command.broadcast = true;
    command.data.dataChar = frameChar;
    command.frameDelayMs = (uint16_t)frameRank * frameInterval;
    return true;
  }
  uint8_t id = EepromStore::getModuleId();
  if (id != EepromStore::UNPROVISIONED_ID && framePos / 2 == id) {
    if (framePos & 1) {
      frameRank = c > '!' ? c - '!' : 0;
      frameHit = true;
    } else {
      frameChar = c;
    }
  }
  if (framePos < 0xFFFF) framePos++;
  return false;
}

bool Transceiver::poll(Command& command) {
  uint32_t safety = millis();
  while (Serial.available() > 0) {
    char c = Serial.read();
    lastSerialTime = millis();
    if (inFrame) {
      if (frameByte(c, command)) return true;
      continue;
    }
    // Command is complete
    if (c == '\n') return parseBuffer(command);
    if (bufferLen < BUFFER_SIZE - 1) {
      buffer[bufferLen++] = c;
      if (c == ':') checkFrameHeader();
    }

    if (lastSerialTime - safety > 500) {
      bufferLen = 0;
      inFrame = false;
      return false;
    }
  }

  // Timeout: if we're mid-command and no byte has arrived in 50ms, treat
  // whatever is in the buffer as complete and return it. Handles messages
  // that don't have an explicit terminator or whose terminator was missed.
  if (bufferLen > 0 && millis() - lastSerialTime > 50) {
    if (inFrame) {
      // A frame that stalls is dropped rather than half-applied.
      inFrame = false;
      bufferLen = 0;
      return false;
    }
    return parseBuffer(command);
  }

  return false;
}
