mdub555/SplitFlapDisplay/(commit log)

2026-08-14 Major refactor/rewrite of CAD models and firmware.
    The CAD models originally required many bolts and nuts to assemble,
    so I modified them to be assembled purely with tabs and clicking
    together, which greatly simplifies the whole process. I do still
    use 1 bolt as the axle, but no nut is required.
    Another major change with my physical design is that it doesn't use
    a Hall effect sensor to detect home, it instead uses two wires near
    the front of the housing that touches the flaps as they go past.
    The home flap has a thin strip of aluminum tape to complete the
    circuit. This removes a lot of variability in the magnet and Hall
    sensor, which I'm hoping makes the nudging and per-module home
    offset f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
    [Center Gear.FCStd, Character Drum - Character Drum Lip.FCStd, Character Drum - Character Drum Main.FCStd, Flap 57 - Blank.FCStd, Gear Plate.FCStd, Module Enclosure - Enclosure Cover Back.FCStd, Module Enclosure - Enclosure Cover Bottom.FCStd, Module Enclosure - Enclosure Cover Top.FCStd]
2026-08-30 New PCB, plus major refactor of frontend code
    The PCB was recreated to use a 5V input voltage, and
    use the ATTiny816, add a debug output pin, and change
    how the home sensor is plugged in.
    The frontend code was split into a bunch of smaller files,
    though I want to continue refactoring.
    I also made some slight changes to the enclosure to better
    fit the PCB and hopefully not require any fasteners to
    hold the PCB in place.
    [BOM File.xls, BOM-bus-board-8-module.csv, BOM-driver-v5.csv, Character Drum - Character Drum Lip.FCStd, Character Drum - Character Drum Main.FCStd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]
2026-09-01 Fixed some bugs and aligned the firmware with the final PCBs
    The EEPROM wasn't getting initialized, and the motor was rotating in
    the wrong direction. This also extracts the pinout to a separate file
    for easier modification.
    [Module Enclosure - Enclosure Cover Back.FCStd]
2026-09-11 Slightly improve firmware to handle drifting from home
    [Din Rail Spacer.FCStd, Module Enclosure - Enclosure Cover Back.FCStd]
2026-09-13 Fixed major error compensation bug
    This bug caused the homing cycle to completely not work on startup
    by overshooting the home sensor and eventually stopping from the
    safety check.
    Reduces the flash baud rate which significantly improved the
    consistancy of the flashing. With the default 230400 baud, flashing
    sometimes took 150+ attempts. With the slow 57k baud rate, flashing now
    succeeds in 1-2 attempts.
    Adds some software debouncing for the home sensor.
    Removes some compilation inlining, which was causing compilation to fail
    with a link-time optimization error where address jumps were too far
    apart.
    [home_sensor.cpp, splitflap.cpp, splitflap.h]
2026-09-26 Add configuration options to the module firmware.
    You can now control the motor power directly, the nudge works again
    (though it doesn't save a new home position), and you're able to set
    the current position as the home offset (by sending 0 as the home
    offset).
    [eeprom_store.cpp, eeprom_store.h, motor.cpp, motor.h, splitflap.cpp, splitflap.h]
2026-09-28 Fix a bunch of small bugs
    [charset.py, eeprom_store.cpp, serial_link.py, splitflap.cpp]
2026-09-28 Fix some more bugs
    [player.py, serial_link.py, test_serial_link.py]
2026-10-05 Added a few more commands to the firmware for on-the-fly configuration.
    See tranceiver.[h|cpp] for the full set of commands.
    You can now disable the constant home adjustment, change the default
    speed of rotation for normal use and for homing, and change the
    debounce timing.
2026-10-05 Fixed minor bug causing debounce to be limited to 8 bits.
    Using EEPROM.put() and EEPROM.get() allows it to use the full 16
    bits expected.
    [eeprom_store.cpp]
2026-10-06 Validate input ranges, make some optimizations, and fix small bugs.
    [debug_serial.h, motor.cpp, splitflap.cpp, splitflap.h, splitflapfirmwarev8.ino]
2026-10-06 Add some major improvements to the firmware
    * make the motion non-blocking
    * allow the motor to accelerate and decelerate
    * give the drum time to settle before releasing
    * add commands to configure these things
2026-10-06 Update the frontend to account for recent firmware changes
    Use the status led for status updates. Allow resetting the
    module. Update the debug output to reduce size. Add a revolution
    counter to track module wear over the lifetime of the module.
    [debug_serial.h, eeprom_store.cpp, eeprom_store.h, module_protocol.py, serial_link.py, splitflap.cpp, splitflap.h]
2026-10-06 Add a file missed in the last commit
    [test_player.py]
2026-10-06 Refactor v8 firmware for readability and structure
    - Rename the misspelled tranceiver.{h,cpp}/Tranceiver to transceiver/Transceiver.
    - Parser: replace the letter switch, the LIMITS table and the per-command
    arg switch with one COMMANDS table (letter + argument kind per command).
    Dedupe the parse-and-reset code in poll() into parseBuffer().
    - Main sketch: move command dispatch into handleCommand() and dump
    scheduling into requestDump()/updateDump(); name the status LED blink rates.
    - SplitFlap: name the flap index sentinels (FLAP_UNKNOWN, FLAP_BETWEEN,
    NO_PENDING_FLAP), extract flapIndexOf(), drop the unused isHome().
    - EepromStore: one set of DEFAULT_* constants, used by writeDefault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
    [eeprom_store.cpp, eeprom_store.h, module_protocol.py, motor.cpp, motor.h, player.py, splitflap.cpp, splitflap.h]
2026-10-06 Store each command's type in the transceiver's COMMANDS table
    Each entry now names its CommandType, and findCommand() returns the
    matching entry, so the table no longer has to follow the enum's order
    and the int-to-enum cast is gone. CommandType gets a uint8_t base to
    keep the rows small.
    Claude-Session: https://claude.ai/code/session_01JSy1fBi4CetwQr9cxVaLvx
    [transceiver.cpp, transceiver.h]
2026-10-06 Fix motion, offset and parsing bugs in the v8 firmware
    - Startup stagger: update() returned early while waiting for the stagger,
    so a move received in that window didn't start until it passed (up to
    ~65 s for high IDs). Only the auto-home waits now.
    - stop() returned early when idle, so it didn't cancel a frame character
    still waiting on its cascade delay.
    - 'o0' saved the position past flap 0 as the offset, dropping the existing
    offset; it now saves old offset + position and makes here flap 0.
    - Changing the home offset or total steps left the tracked position in the
    old frame, so later moves landed in the wrong place until the next home
    edge. A changed value now marks the posit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
    [splitflap.cpp, splitflap.h, splitflapfirmwarev8.ino, transceiver.cpp, transceiver.h]
2026-10-06 Reorganize splitflap.cpp around the update loop and operation phases
    - A comment at the top lists the phases each operation goes through
    (move, home, calibrate) and how they chain.
    - update() reads as its steps: start due work, handle idle/settle/arrival,
    wait for the step delay, step, then afterStep(). The per-phase handling
    is split into afterSeekStep(), afterMeasureStep(), stepDelay(),
    startDueWork() and saveRevolutionsIfDue(); the home-edge correction
    moves out of stepAdvance() into onHomeEdge().
    - The .cpp is in labelled sections in the same order as the header:
    setup and the update loop, motion commands, settings that move flap 0,
    status, starting and ending operations, p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
    [splitflap.cpp, splitflap.h]
2026-10-06 Time motor steps in microseconds
    The step, homing step and ramp start delays are now microseconds
    (1-65535) instead of milliseconds (1-255), so they can be tuned
    between whole milliseconds. Stepping is timed with micros().
    Firmware:
    - The three delays are stored as uint16 in EEPROM, which moves the
    fields after them. INIT_VALUE goes to 0x07, so a module resets to the
    defaults on first boot (including its ID and revolution count).
    - Defaults keep the old timing: 1000 / 1000 / 3000 us.
    - 'k', 'l' and 'u' take microseconds. They share ARG_INT_NONZERO with
    't', replacing ARG_INT_DELAY and ARG_INT_TOTAL_STEPS.
    - The ramp is computed in 32 bits. The settle time stays in ms.
    - The dump repor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
    [eeprom_store.cpp, eeprom_store.h, module_protocol.py, serial_link.py, splitflap.cpp, splitflap.h, splitflapfirmwarev8.ino, test_firmware_routes.py]
2026-10-06 Reassign the bus command letters by kind
    Lowercase letters (and - +) are actions, punctuation is about the module
    itself, and uppercase letters are settings saved to EEPROM:
    actions - char, + index, h home, c calibrate, n nudge, g go to step,
    x stop, e exercise, b blink (identify), r reboot, f frame
    module ? dump, ! reset settings, @ set module ID
    settings O offset, T total steps, D debounce, E recalculate at home
    edge, A auto-home, C clockwise, F free coils, S step delay,
    H homing step delay, R ramp start delay, L ramp length,
    W settle wait, P power-on stagger
    The dump reply is marked with the dump letter (m05?:...), and the fram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
    [module_protocol.py, player.py, serial_link.py, splitflapfirmwarev8.ino]
2026-10-06 Centralize the bus command letters in module_protocol.py
    module_protocol.py now holds every command letter (Cmd, named as in the
    firmware's CommandType), the broadcast ID, the unprovisioned ID, a
    message() builder and the dump reply regex. Every place that sent or
    parsed a command (serial_link, player, backup restore, the module,
    settings and control routes, and the debug panel's quick commands,
    now passed to the template from app.py) uses them instead of spelling
    out letters.
    tests/test_module_protocol.py reads the firmware source and checks that
    Cmd matches its COMMANDS table and frame/dump letters, and that the dump
    slot and unprovisioned ID match, so the two can't drift apart.
    Co-Autho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
    [module_protocol.py, player.py, serial_link.py]
2026-10-06 Store the module settings as one EEPROM block
    All settings except the revolution count now live in one Config struct,
    stored as a single block: begin() loads it, and each saver updates the
    RAM copy and writes the block back with EEPROM.put(), which only rewrites
    the bytes that changed. This replaces the per-field address map, the
    bit-packed booleans and the 14 separate default writes, and frees 550
    bytes of flash. The defaults are one const Config.
    writeDefaults() now writes the magic value last, so a power cut part way
    through starts again from the defaults. INIT_VALUE goes to 0x08 for the
    new layout.
    Claude-Session: https://claude.a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
    [eeprom_store.cpp, eeprom_store.h]
2026-10-06 Label the dump reply's fields, and show them in the debug panel
    The dump reply is now m<ID>? followed by a tab, a label and the value for
    each field, e.g. m05?<TAB>O480<TAB>T4096<TAB>...<TAB>#12<TAB>~-3. A
    setting is labelled with the letter that sets it; revolutions and drift
    use # and ~. The firmware looks each setting's label up in COMMANDS, so
    the letters are still defined once. The reply is ~15 bytes longer, so
    the broadcast dump slot goes from 90 to 105 ms.
    Frontend:
    - module_protocol.py defines the fields (DUMP_FIELDS: label, settings
    key, kind, name and unit) and parses replies by label, in any order. A
    reply with a missing, unknown, repeated or malformed field is rejected.
    - GE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
    [module_protocol.py, serial_link.py, splitflapfirmwarev8.ino, test_module_protocol.py, test_serial_link.py, transceiver.cpp, transceiver.h]
2026-10-07 Frontend backend: share route helpers and remove duplicated logic
    - routes/common.py: json_body(), error(), is_int() and sse_response(),
    replacing the hand-written error responses, int checks and the two
    copies of the SSE generator. The blueprint list moves to app.py so the
    routes package stays cheap to import.
    - module_routes: a @provisioned decorator replaces eight copies of the
    "unprovisioned module" lookup. Status codes are now consistent: 404
    for an unprovisioned module (calibrate gave 500), 504 when a module
    doesn't answer (calibrate gave 500, sync gave 200 {"status":
    "failed"}). /adjust now rejects a non-integer delta and an offset
    outside 1..total steps - 1 instead of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
    [charset.py]
2026-10-07 Apps: shared animation base class and helpers
    - AnimationApp builds the style and speed settings from the app's key
    and runs the frames; Rainbow, Sweep, Checker and Twinkle now only
    describe their frames. Every animation offers all the styles.
    - App.setting() falls back to the app's own field default, so defaults
    are written once (Metro's stop and route defaults now take effect).
    - Shared clock(), split_list() and row_frames() replace repeated
    strftime, comma-list and frame-building code.
    - DashboardApp reuses weather_page(), and MatrixApp reuses
    matrix_burst_frames() instead of copying them.
    Claude-Session: https://claude.ai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
2026-10-07 Restore the request import in the settings and playlist routes
    The previous refactor dropped it while those routes still read
    request.method, so GET/POST /settings and /playlists failed with a
    500. Adds tests for both blueprints, which had none.
    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
    [test_settings_routes.py]
2026-10-07 Page: render shared data server-side, dedupe the scripts, tidy the CSS
    Template and configuration
    - routes/pages.py serves the page with CONFIG (grid size, flap
    characters, how codes are shown, colour tiles, animation styles,
    timing fields, dump format) rendered in, so the scripts no longer keep
    copies of charset.py, layout.py or module_protocol.py tables, and the
    page no longer fetches /config or /serial/dump_format.
    - The firmware settings form and the module toggles are rendered from
    GLOBAL_SETTINGS and MODULE_TOGGLES, which now carry their labels and
    hints. Jinja macros replace the repeated banner/live-display, toggle,
    manual-control and offset-button blocks, and loops the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
    [charset.py, module_protocol.py, pages.py, test_pages.py]
2026-10-07 Add v8 RS-485 tester script covering the full v8 command set
    Copies splitflap_test.py from the v7 firmware and updates it to the v8
    protocol: renamed commands (nudge n, dump ?, set ID @, uppercase settings),
    the new actions (stop, exercise, identify, reboot, frame broadcast), the
    module commands (reset settings), every EEPROM setting, the v8 flap set,
    and decoding of dump replies.
    Claude-Session: https://claude.ai/code/session_01Apd9R9GyxPghrbmb2r17xz
    [splitflap_test.py]
2026-10-07 Make Debug its own page with every firmware command
    The serial debug side panel becomes a Debug tab like the others. It can
    send everything splitflap_test.py can: pick a module ID (or broadcast),
    choose a command from a grouped dropdown, and fill in its inputs, with a
    live preview of the exact message. Calibrate can be followed by a dump,
    frame broadcasts take text, interval and order, destructive commands ask
    first, and raw messages are sent as typed. The serial log and a clickable
    flap character table sit below.
    The command catalog lives in display/debug_commands.py and reuses the
    protocol's letters, ranges and hints; FRAME_MAX_MODULES moves to
    module_protocol so the page doesn't import t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
    [debug_commands.py, module_protocol.py, pages.py, player.py, test_pages.py]
2026-10-07 Fit the module grid and inspector buttons on phone screens
    On narrow screens the module grid was forced into a single row of 64
    cells. It now wraps to at most 8 columns, so all 64 fit on screen with
    cells big enough to tap. The column count moves from an inline style to
    CSS so the phone layout can override it. The inspector's row of three
    buttons also wraps instead of pushing the page wider than the screen.
    Claude-Session: https://claude.ai/code/session_01NdRg3cuWLHnRCf8svN7znV
2026-10-07 Add degree and heart buttons to the compose palette
    Keyboards don't have ° or ♥, so they get buttons after the colour tiles,
    drawn like flaps, that type at the cursor. They come from SYMBOL_TILES in
    charset.py, which also maps them to their wire codes. On phones the
    palette's tiles shrink a little so all ten fit on one line.
    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
2026-10-07 Make auto-home and release motor settings for all modules
    Auto-home on boot and release motor when idle are now shared by every
    module, like the timing settings: they sit in that section (renamed
    Settings for All Modules) and Apply to All Modules broadcasts them. The
    inspector's per-module toggles are down to motor direction, and the
    Global Settings auto-home switch and its /toggle_autohome route are gone.
    An existing settings.json is migrated on load: the old auto_home switch
    becomes the shared auto-home value, and release motor carries over if
    every module had the same value. Backups now carry the shared settings,
    restore broadcasts them, and an older backup is migrated the same way.
    The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
2026-10-07 Show and stop playlists, flag simulation mode, keep drafts, add a schedule
    - The live state now says what's playing: an app, or a playlist with its
    name and current page, and whether the schedule started it. The banner
    shows playlists too, and STOP stops them (it used to stop apps only, and
    a stopped app fell back to the last pushed playlist).
    - A SIMULATION badge next to LIVE DISPLAY shows when the serial port
    didn't open.
    - The Control page keeps its draft (grid, playlist being built, defaults,
    name) in localStorage, so a reload doesn't lose it.
    - Saved playlists are edited in place: Edit keeps the name, Save updates
    it, and saving over a different playlist asks first. Run play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
    [player.py, scheduler.py, serial_link.py, state.py]
2026-10-07 Show Sync All progress on the module grid
    Sync All now reports each module's result over the live state as its reply
    arrives: the module's cell flashes green and fades back, and a module that
    doesn't answer (after one individual retry) turns orange and stays that way
    until it next syncs. The inspector for a failed module says "Sync failed",
    and the button shows SYNCING… while a sync runs, on every open page. A
    single module's Sync EEPROM updates the same status. The finishing toast
    names any modules that failed.
    Claude-Session: https://claude.ai/code/session_015cSayHdd5mZpbT1598aWsK
    [serial_link.py, state.py, test_module_routes.py, test_serial_link.py]
2026-10-08 Add a light theme that follows the system, and an accessibility pass
    Light mode: every colour is now a variable, with light values applied
    under prefers-color-scheme: light. The display boxes keep fixed dark
    colours in both themes. Text and controls meet WCAG AA contrast in both;
    in dark mode the faint greys are lighter and the filled buttons darker so
    white text on them passes.
    Accessibility:
    - Pages are an ARIA tab list with arrow-key navigation; there's a main
    landmark and headings.
    - The module grid is buttons with names that say each module's state,
    one Tab stop, moved round with the arrow keys.
    - App cards are a run button with a separate, named settings button.
    - The settings dia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
    [test_pages.py]
2026-10-08 Keep settings across Docker rebuilds, survive serial unplugs, validate the timezone, back up everything
    - Docker: settings.json now lives on the mounted volume
    (SPLITFLAP_CONFIG_PATH=/code/data/settings.json), so a rebuild no
    longer wipes calibrations, playlists and the schedule. The container
    runs `python app.py` (threaded, starts the background threads) instead
    of `flask run --debug`. The port is configurable (SPLITFLAP_PORT).
    settings.json is written atomically, so a power cut mid-save can't
    leave it half-written.
    - Serial: a failed write or read drops the port instead of crashing the
    playlist loop, and a watchdog reopens it (and notices an unplug while
    idle) every 5 s; th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
    [player.py]
2026-10-08 Add blanking the display by schedule, a preview, playlist renaming and undo
    - Blank: the schedule (a slot or the default) can blank the display for
    quiet hours. It shows a blank page and keeps it blank until something
    else starts; the banner says so, without a STOP button.
    - Preview: plays the page, or the whole playlist in multi-page mode, in the
    compose grid as the display will, from what it shows now: each flap at
    its turn in the transition, turning through the reel at its real speed,
    each page held for its delay. Nothing is sent; typing or clicking in the
    grid ends it. The page config now carries each transition's order, the
    reel speed and the bus time per module.
    - Rename: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
2026-10-08 Show every message sent to the display in the serial log
    Pages (pushed, playlists, apps, the schedule) went to the bus through
    write_serial() directly, which didn't log, so the Debug page's serial log
    never showed them; only messages sent with send_raw() did. Logging now
    happens in write_serial() itself, which every write goes through, as
    SENT, SIMULATED SENT or NOT SENT (serial lost).
    The log also spells out what a frame broadcast puts on the display
    ("page "HELLO / WORLD", modules 21 ms apart"), marks messages that didn't
    reach the bus, and skips a malformed log message instead of stopping.
    Claude-Session: https://claude.ai/code/ses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
    [serial_link.py, test_serial_link.py]
2026-10-08 Serve with gunicorn instead of Flask's development server
    gunicorn.conf.py runs the app as one gthread worker with 16 threads: the
    serial port, the display state and the background threads live in the
    app's process, so it must not have more than one worker, and the live
    streams each hold a thread. No preload (the background threads start when
    the app loads) and no max_requests (a worker restart resets what's
    playing). graceful_timeout is 5 s, since the live streams never end on
    their own and would otherwise hold up every restart for 30 s.
    The Docker image now runs `gunicorn app:app`; `python app.py` still works
    for development.
    Claude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
2026-10-08 Add per-flap offsets to the firmware
    Each flap can now be nudged a few steps from where an even division of the
    revolution puts it, to make up for small differences between reels. The
    offsets are stored in EEPROM, one byte per flap, as steps + 128 (128 = no
    offset), so they go on the wire without a sign.
    'J' sets them, on one module only (a broadcast is ignored):
    m05J131 sets the offset of the flap showing to +3 steps, then moves to
    its new position (forward for a larger offset, nearly a full
    revolution for a smaller one). Ignored unless a flap other than
    0 is showing; the home offset places flap 0.
    m05J replies, once idle, with every flap's offset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
2026-10-08 Add host tests for the module firmware
    tests/run_tests.sh builds the firmware on the host, against fake hardware,
    and runs 64 tests in about a second. It needs only a C++17 compiler.
    The firmware's sources are compiled unchanged, the sketch included. The
    fakes (tests/fakes) stand in for the clock, the RS-485 port, the EEPROM and
    a reel: the real motor.cpp turns it by its coil patterns, and the real
    home_sensor.cpp reads its home contact. Tests put messages on the bus, let
    simulated time pass, and check where the reel ended up and what the module
    replied. Each test runs in its own process, from a powered-off module with
    blank EEPROM.
    They cover homing, moves, stops and retargeting, calibrat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
2026-10-08 Check the firmware's size, locally and on every pull request
    check_flash.sh builds the firmware for the ATtiny816 with arduino-cli (the
    attiny816 profile in sketch.yaml), with debug output and without, and
    reports the flash and RAM each uses. It fails if either build doesn't fit,
    and warns below 256 bytes of free flash (WARN_FREE to change it).
    The Firmware workflow runs the host tests and the size check for pull
    requests and pushes to main that change the firmware, and puts the sizes
    in the run's summary. .gitignore now keeps .github/.
    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
2026-10-08 Run the firmware tests with GoogleTest and CTest
    Replaces the small hand-written test framework with GoogleTest, built with
    CMake (tests/CMakeLists.txt). CMake uses an installed GoogleTest, or
    downloads v1.15.2 on the first configure. gtest_discover_tests registers
    each test with CTest, which runs it in its own process, so every test
    still starts from a freshly powered-on module.
    The tests are unchanged apart from GoogleTest's names and assertions,
    grouped into suites: Motion, Bus, Frame, Dump, Settings, Startup and
    StatusLed. run_tests.sh configures, builds and runs them through ctest; a
    name filter is passed on as a regex, e.g. run_tests.sh Frame.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
    [harness.cpp, test_bus.cpp, test_module.cpp, test_motion.cpp]
2026-10-08 Build a copy of the sketch without its upload port in the flash check
    arduino-cli looks up sketch.yaml's default_port (/dev/ttyUSB0) even just to
    compile, and stops when nothing is plugged in there: "Error getting port
    metadata: port not found", as on the CI runner. check_flash.sh now builds
    a copy of the sketch whose sketch.yaml leaves out default_port and
    default_protocol, so it works without a module attached.
    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
2026-10-08 Test the per-flap offsets
    Adds the FlapOffset tests: raising an offset moves forward by the
    difference and lowering one goes nearly a revolution, moves use each
    flap's own offset (also after homing), offsets can wrap past either end
    of the revolution, J is ignored for flap 0, between flaps, mid-move,
    unhomed, without a number and as a broadcast, the % dump's hex and its
    wait for idle, offsets surviving a power cycle and being cleared by a
    settings reset, and EEPROM from the firmware before offsets being reset
    to defaults.
    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
    [test_flap_offsets.cpp]
2026-10-08 Fix home sensor, calibration, direction and reset bugs in the v8 firmware
    - Home sensor: a rising edge only counts once the contact has been open
    for the debounce time. Timing from the last accepted edge let a bounce
    count as a new edge when the reel had stopped inside the contact, which
    with recalculate-home on snapped the position to the wrong place. The
    first edge after power-on is no longer ignored either.
    - Calibrate searches at least the longest revolution it accepts, so it can
    fix a total steps setting that is far too small (e.g. 2048).
    - Changing the motor direction ('C') stops the reel and forgets the
    position, as 'O' and 'T' do, instead of counting a reversed reel forwa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
    [EEPROM.h, eeprom_store.cpp, eeprom_store.h, firmware.cpp, home_sensor.cpp, home_sensor.h, splitflap.cpp, splitflap.h]
2026-10-08 Shrink the firmware: cheaper bug fixes, and build the globals at compile time
    The last commit's fixes cost 274 bytes of flash (7806 -> 8080 in the debug
    build). Measured one by one, most of it came from a few spots, now
    rewritten to do the same for less:
    - The home offset wrap used %, which linked in a 16-bit division routine
    (76 bytes). It's now a subtraction loop where the home edge is worked
    out, and the stored offset is left as it was.
    - The home search limit's saturating add cost more than its check; it now
    compares without adding, and a calibration simply searches the longest
    revolution it accepts.
    - The overshoot check compares the recomputed distance with the old one
    inste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
    [eeprom_store.cpp, eeprom_store.h, home_sensor.cpp, splitflap.cpp, splitflap.h, test_motion.cpp, transceiver.h]
2026-10-09 Move the Modules page's explanations behind info buttons
    The Modules page explained most fields in text beneath them, which made
    it long. Each explanation is now behind an ⓘ next to its name: it shows
    while the button is hovered or focused, or once it's clicked (it then
    stays until it's clicked again, another opens, Escape is pressed or the
    page is clicked elsewhere). The info() macro makes them, and info.js
    opens and closes them.
    - Settings for All Modules: every field's hint, and the section's note.
    - The inspector: the revolutions and drift stats (from their hover-only
    titles), the home offset buttons, Motor clockwise, Total steps, Go to
    step, Exercise and the flap offset tuner.
    -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
2026-10-09 Collapse the flap offsets, step them by 4, and pick a character to show
    - The inspector's Flap offsets section opens and closes (a <details>),
    and starts closed. Its ⓘ shows its explanation without toggling it.
    - The tuner's buttons shift the flap showing by 4 steps instead of 1.
    - Show character is a dropdown of every flap on the reel, named as the
    Debug page names them (blank, A, ..., 🟥 (r)), and shows the one
    chosen by index, so a code like r can't be mistaken for the letter R.
    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
2026-10-09 Put Home Motor at the top of the inspector, next to Sync EEPROM
    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
2026-10-09 Split the inspector into actions and settings
    The inspector mixed things to do with a module and its settings. It's now:
    - Home Motor and Sync EEPROM at the top, then the actions right below
    them: Show character, Go to step and Exercise.
    - The stats and the timing line from the last sync.
    - One box of the module's settings: the home offset buttons (now -16
    to +16; the +-32 pair is gone), Motor clockwise and Total steps.
    - Flap offsets, then Measure Reel, Identify, Reboot and Reset Settings.
    Both boxes are disabled for an unprovisioned module, apart from their ⓘ
    buttons, which now stay usable there too.
    Claude-Session: https://c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
2026-10-09 Show the module's status as one line
    The inspector showed four big stats and a paragraph of timing values. Two
    of the stats were settings shown twice, and the timing values only matter
    when they differ from the shared settings. Now:
    - One status line under the title: revolutions, drift, whether the
    timing settings match the shared ones, and Sync failed when it did.
    - Drift is green under 8 steps either way, orange under 16, red from 16.
    - The timing summary is "✓ Matches the shared settings", names the one
    setting that differs ("⚠ Debounce is 100 ms here, 50 ms shared"), or
    counts several. Its ⓘ lists every value, highlighting any that differ.
    - The home offset's value sits in i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
2026-10-09 Tune the flap the picker shows, from the settings
    The flap picker already moves a module to any flap, so the Flap offsets
    section's Previous and Next buttons and its own flap display are gone,
    along with the section. What's left, the offset of the flap the module is
    showing, is a row in the module's settings under Home offset: "Offset of
    flap D" with -4, the offset, +4 and SET, and the flaps with an offset
    listed under it.
    The picker now moves the module through the flap offset row's show_flap
    request, which answers once the reel has stopped with every flap's
    offset, so the row shows the offset of the flap just picked. A flap
    picked while the row is busy waits its turn. When the module does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
2026-10-09 Draw flaps in Kosugi Maru, the font on the physical flaps
    Everything drawn as a flap now uses Kosugi Maru: the live display, the
    compose grid and the page previews, the flap picker, the ° and ♥ buttons
    and the Debug page's flap table (--flap-font in base.css, falling back to
    the monospace font before then).
    The font is served from static/fonts rather than Google Fonts, so the
    page needs no internet connection: just the two subsets the flaps need,
    Latin (letters, digits, punctuation, °; 8 KB) and the one holding ♥
    (12 KB), with its Apache 2.0 licence. A test checks that every file the
    stylesheets point to exists.
    Claude-Session: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
2026-10-11 Test On This Day against the real Wikipedia feed
    The start of Wikimedia's on-this-day feed for 11 Oct (each event's pages
    cut down, as the app doesn't read them) parses as the app expects: a
    year and a text for each event.
    Claude-Session: https://claude.ai/code/session_01S7DAkrh8kvTYiGa42Qbuaq
2026-10-11 Add a Spotify app, and OAuth sign-in any app can use
    apps/oauth.py signs an app in to a service with the authorization code
    flow and PKCE, so most services only need a Client ID. An app sets
    `oauth = OAuthProvider(...)`; its settings modal gets an account section
    with Connect and Disconnect, and get_pages() calls
    self.access_token(settings) for a token that's refreshed when it runs
    out. The same four routes (routes/oauth_routes.py) serve every such app.
    The service sends the browser back to this server's callback, unless the
    provider sets a fixed redirect address. Spotify only allows http:// for
    loopback ones, and the Pi is reached over http on the LAN, so it uses
    http://127.0.0.1:8888/call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
2026-10-11 Let playlists include apps, showing one item each time round
    A playlist step can now be an app, {app, delay}, alongside pages of
    text: "+ Add App" under the playlist adds one. Each time round the
    playlist, an app step shows the app's next item, so On This Day shows
    one event, the playlist moves on, and the next time round it shows the
    next event. The step stays up for at least its delay; an app whose item
    is over sooner (a clock) is refreshed until it has been.
    Apps whose content splits up implement the new App.get_items(), a list of
    items each a list of Frames; get_pages() is then all of them in turn, and
    an app that only has get_pages() is one item. On This Day (an event
    each), YouTube Co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
